htrinkle/FPGA/README.md

# FPGA Playground

## Analogue Acquisition Board

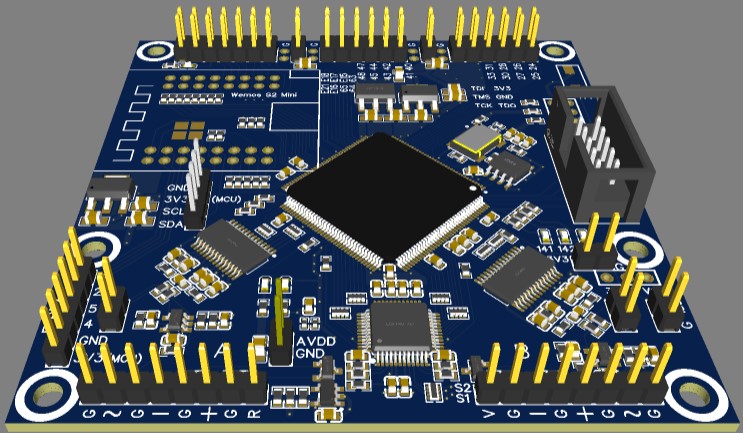
[picture p1: images/FPGA_Analog_Board_3d.jpg]
isolated


[FPGA Analogue Board WIKI](https://github.com/htrinkle/FPGA/wiki/FPGA-Analogue-Board)
