htrinkle/FPGA/images/FPGA Analog Board IO Headers.jpg

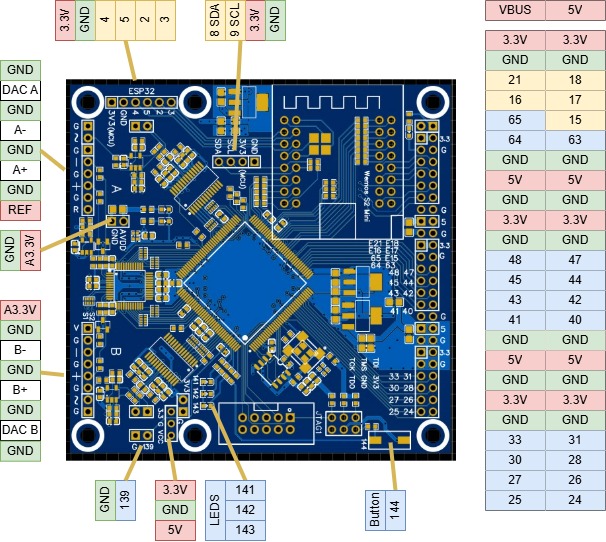
images/FPGA Analog Board IO Headers.jpg
