htrinkle/FPGA/images/FPGA Analog Board Top View.jpg

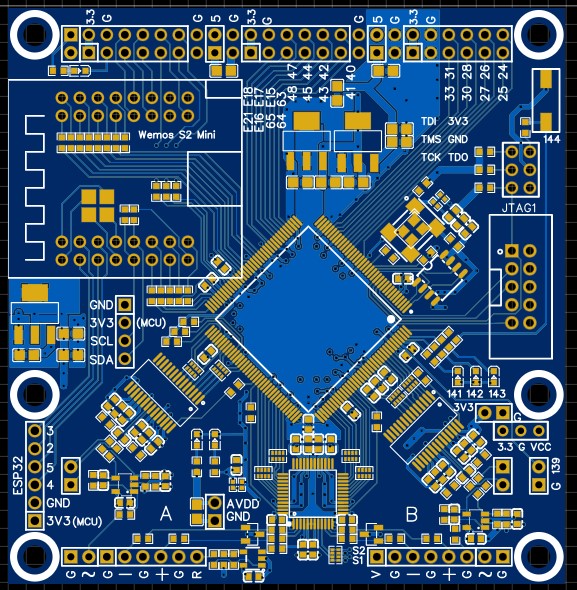
images/FPGA Analog Board Top View.jpg
