htrinkle/FPGA/images/FPGA Analog In.jpg

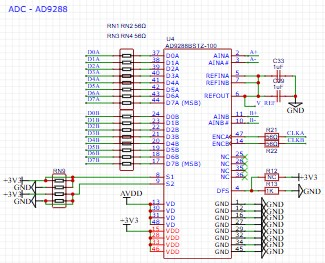
images/FPGA Analog In.jpg
