htrinkle/FPGA/images/FPGA Analog Out.jpg

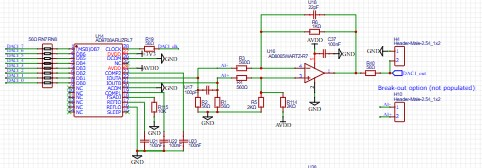
images/FPGA Analog Out.jpg
