htrinkle/FPGA/images/FPGA JTAG and AS Config.jpg

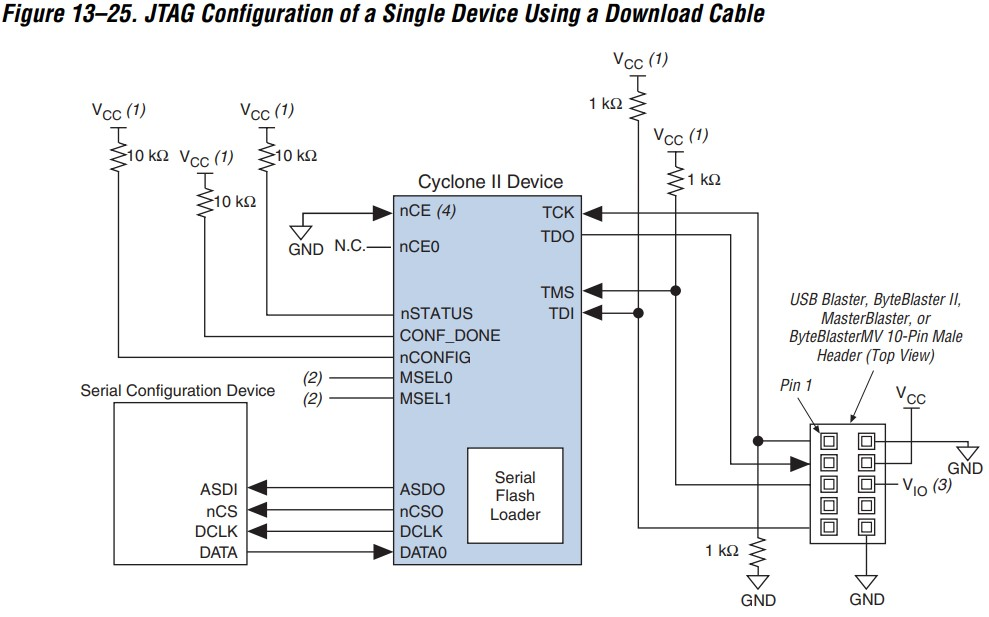
images/FPGA JTAG and AS Config.jpg
