htrinkle/FPGA/images/Lolin FPGA.jpg

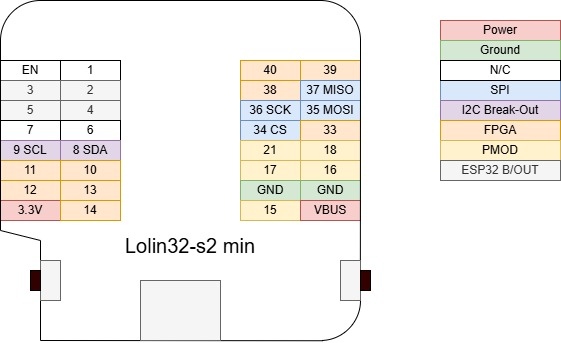
images/Lolin FPGA.jpg
