htrinkle/FPGA/images/thumbnail_PXL_20250319_053721011.jpg

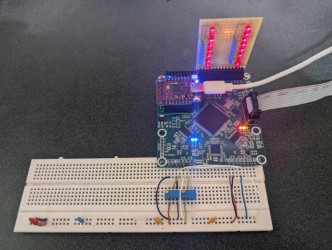
images/thumbnail_PXL_20250319_053721011.jpg
