htrinkle/FPGA/DSO/verilog/counter_sre.v

module counter_sre #(
	parameter Bits = 8
)(
	input wire clk,
	input wire en,
	input wire sync_reset,
	output reg [Bits-1:0] q = 0,
	output wire carry
);

assign carry = &q;

always @(posedge clk)
begin
	q <= (sync_reset) ? 0 : (en) ? q + 1'd1 : q;
end

endmodule
