htrinkle/FPGA/(commit log)

2025-02-21 3D Render of Analog Board
2025-03-03 ADC Ramp Test
2025-03-07 SPI Interface Verilog
2025-03-08 Working SPI
    Initial working version of SPI module
    Does not implement ADC buffer read yet, just register read/write. Also no read/write control yet.
2025-03-10 update spi
2025-03-13 SPI Memory Reader Tested
2025-03-16 Working SPI Register
    Tested:
    - Register 0 read/write
    - Register 1 read from ADC on [15:8] and [7:0]
    Memory read not tested
    Memory write not implemented
2025-03-19 Add files via upload
    Testing the Analog Board
2025-04-01 updated adc driver
